shaharTechGit/Generic_Gate_Driver/Project_Book_8034_GENERIC_GATE_DRIVER_v110525_git.pdf

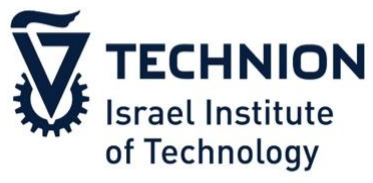
[picture p34: figure]
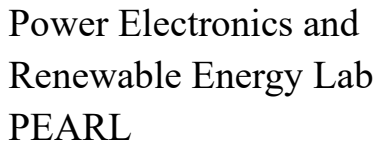
[picture p35: figure]
Power Electronics and Renewable Energy Lab PEARL

GENERIC GATE DRIVER

# Generic Gate Driver

# IGBTs, CoolSiC, USiC

# EVALUATION OF

# Infineon EiceDRIVER

# חורף תשפ"ה

# ספר פרויקט - 8034

## מבצעים: מאור ושחר

## מנחה: אריק

תודות

ילנה )ומנשה( –

עם המון סבלנות, עזר ו לבחון ולבחור בפתרונות. כמובן גם לחבר ולנתק ולספק

את העזרים הנדרשים.

לידור )ותום( –

עם התעניינות, שאלות קטנות במעבדה, עזרה במדידות ועבודה עם מכשירים.

אריק –

שהקשיב לנו, הב ין אותנו, עזר, דחף קדימה וגם שחרר כשהיה צריך.

הכל בצורה נעימה ועם חיוך.

תוכן עניינים

רשימת איורים 4 |
.1 תקציר5 |
.2 רשימת קיצורים 6 |
.3 מבוא 6 |
.3.1 הגדרות ושפה משותפת7 |
.3.2 עבודות קודמות 7 |
.3.3 מבנה העבודה – שלבים8 |
.4 תיאור כללי של הכרטיס והמערכת 9 |
11 | )Arduino Uno R3( | בקר | - | מיקרו | .4.1
.4.2 אספקת המתח במעגל12 |
.4.3 תשתית חיבור ובקרה 12 |
.5 רכיבים מרכזיים במערכת 12 |
12 | Infineon 1ED3321MC12N – | הדרייבר | .5.1
13 | Infineon IKW40N120H3 - IGBT | טרנזיסטור | .5.2
13 | UnitedSiC UJ4C075018K3S - SiC MOSFET | טרנזיסטור | .5.3
.6 פירוט תהליך הפיתוח ושלבי העבודה 14 |
.6.1 שלב ראשוני – הפעלה בסיסית של הכרטיס 14 |
.6.2 הפעלה עם מתח גבוה ובדיקות עומס 15 |
6.3. החלפת הטרנזיסטורים והגדרת התאמות 15 |
6.4. שיקולים נוספים ותכנון מבנה גנרי 16 |
.7 ניתוח תוצאות 16 |
.8 מסקנות והמלצות 17 |
8.1. מסקנות עיקריות17 |
8.2. אתגרים שעלו 17 |
.8.3 המלצות להמשך17 |
.9 נספחים 19 |
9.1. בדיקות ותוצאות 19 |
9.2. קוד בקר ארדואינו 19 |
9.3. פתרון אלטרנטיבי - מעגל תומך 19 |
9.4. הוראות הפעלה 20 |

9.5. קישורים - לינקים 20 |
.10 רשימת מקורות 21 |

רשימת איורים

7 | Infineon Eval-1ED3321MC12N - | איור | 1 Figure
Figure 2 איור – דיאגרמת בלוקים של שלבי העבודה 8 |
Figure 3 איור - דיאגרמת החיבורים 9 |
Figure 4 איור – טרנזיסטור עליון HS פתוח להולכה 10 |
Figure 5 איור - טרנזיסטור תחתון LS פתוח להולכה 10 |
Figure 6 איור – טבלת מצבי ההפעלה 11 |
Figure 7 איור - מיקרו-בקר ארדואינו, המחשה של זמן מת 11 |
13 | Infineon 1ED3321MC12N | דרייבר | - | איור | 8 Figure
13 | IGBT - Infineon IKW40N120H3 | טרנזיסטור | - | איור | 9 Figure
14 | SiC MOSFET - UnitedSiC UJ4C075018K3S | טרנזיסטור | - | איור | 10 Figure
Figure 11 איור - PWM גל משלים מהמיקרו בקר 14 |
Figure 12 איור -סכימת חיבור נגדי העומס בצד המתח הגבוה 15 |
Figure 13 איור - פתרון אלטרנטיבי מעגל תומך 19 |
Figure 14 איור – פתרון אלטרנטיבי חיבור למעגל הקיים 20 |

## .1 תקציר

במסגרת פרויקט זה נבחן ואופיין כרטיס אב -טיפוס של חברת Infineon דגם

N12MC3321ED-1Eval, המשמש כדרייבר מבודד להפעלת טרנזיסטורים מסוג

IGBT בתצורת Bridge-Half. המטרה המרכזית של הפרויקט הייתה לאפשר

שימוש גמיש בכרטיס, כך שיתאים גם לטרנזיסטורים מסוג MOSFET SiC

(Carbide Silicon(, ובכך להרחיב את השימושיות שלו לטובת פרויקטים עתידיים

במעבדת הספק.

במסגרת העבודה נותח מבנה הכרטיס והוגדרו ההתאמות הנדרשות להחלפת

סוג הטרנזיסטורים, תוך התחשבות בשוני בין הטכנולוגיות מבחינת מאפייני

מיתוג , דרישות מתח ובטיחות. פותח סט-אפ ניסיוני הכולל מיקרו-בקר ליצירת

אותות PWM מותאמים, ונבחנו מדידות מייצגות למתחי ם השונים

על-גבי שני סוגי הטרנזיסטורים. | DV ,GV ,CV , GV

התוצר הוא תשתית גנרית להפעלת טרנזיסטורים בתצורת Bridge-Half,

שתאפשר שימוש חוזר , בטוח וגמיש בכרטיסים קיימים במעבדה לצרכים

ניסיוניים מגוונים.

## Abstract

This project focuses on the evaluation and adaptation of Infineon's Eval-

1ED3321MC12N evaluation board, originally designed as a dual-channel

isolated gate driver for IGBT transistors in a Half-Bridge configuration.

The main objective was to enable flexible use of the board with additional

transistor types—specifically, SiC MOSFETs (Silicon Carbide)—thereby

extending its applicability for future power electronics experiments in the lab .

The internal structure of the board was analyzed, and the necessary

adjustments for replacing the original IGBTs were defined, with attention to

differences in switching behavior, voltage requirements, and safety

considerations across technologies .

A dedicated experimental setup was developed using a microcontroller to

generate complementary PWM signals with appropriate dead time, and

representative measurements of Vge, Vce, Vgs, and Vds were performed for

both transistor types .

The result is a generic, lab-grade Half-Bridge gate driver platform that

enables safe, reusable, and flexible testing of various power transistors using

the same evaluation board.

## .2 רשימת קיצורים

Evaluation Board כרטיס בדיקה והערכה של רכיבים | Eval Board
Insulated Gate Bipolar Transistor | IGBT
Gate–Emitter Voltage Collector–Emitter Voltage | VGE VCE
Metal–Oxide–Semiconductor Field-Effect Transistor | MOSFET
Gate–Source Voltage Drain–Source Voltage | VGS VDS
Silicon Carbide | SiC
Pulse Width Modulation מיתוג באמצעות שינוי רוחב פולס | PWM
גבוה מתח – High Voltage | HV
Low-Side / High-Side צד עליון / צד תחתון | LS/HS
Printed Circuit Board מעגל מודפס | PCB

## .3 מבוא

במסגרת פרויקטים שונים המתבצעים במעבדת הספק, קיים צורך בתשתיות

מודולריות להפעלת טרנזיסטורים מסוגים שונים, תוך תמיכה בטופולוגיות מיתוג

. | וכדומה | Half-Bridge, Buck, Boost | כגון | מגוונות

השימוש בכרטיסים מוכנים מראש לצרכי ניסוי, פיתוח ואפיון , מאפשר חיסכון

ניכר בזמן, עשוי למנ וע שגיאות חיווט, ולתרום לסטנדרטיזציה של ניסויים.

תמונות הכרטיס שנבחר כבסיס לעבודה, N12MC3321ED-1Eval Infineon,

מופיע באיור .1 הכרטיס תוכנן במקור עבור הפעלת טרנזיסטורים מסוג IGBT,

אולם בפרויקט נבחנה האפשרות להרחיב את שימושו להפעלת טרנזיסטורים

מסוג MOSFET SiC. טרנזיסטורים מתקדמים בעלי יתרונות בולטים במהירות

מיתוג, עמידות תרמית, יעילות וכן היכרות טובה יותר של סטודנטים עם אופן

הפעולה שלהם.

המוטיבציה לפרויקט נובעת מן הצורך לאפשר גמישות בניסויים עתידיים, מבלי

להידרש לתכנון חומרה ייעודית לכל טכנולוגיה מחדש.

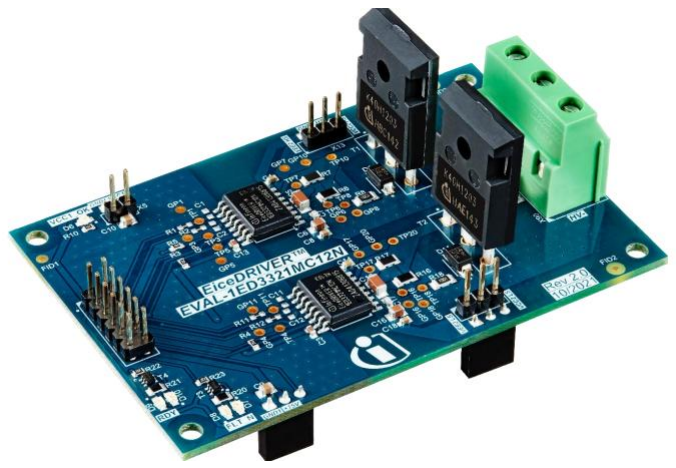
[picture p36: figure]

Infineon Eval-1ED3321MC12N - איור 1 Figure

.3.1 הגדרות ושפה משותפת

Driver Gate – רכיב המשמש לשליטה ישירה על שערי טרנזיסטורים, תוך

התאמת מתחי ם, בקרות הפעלה והגנות.

MOSFET SiC / IGBT – טכנולוגיות טרנזיסטור שונות, כל אחת בעלת מאפיינים

ייחודיים מבחינת מתחי הפעלה, קצב מיתוג, עמידות לרעש ועוד.

Time Dead – מרווח זמן בין כיבוי של טרנזיסטור אחד להפעלת השני בצד הנגדי

של Bridge-Half, שנועד למנוע מצב של through-shoot וסיכון הרכיבים.

Protection DESAT – מנגנון הגנה מפני זרמי יתר, באמצעות זיהוי עלייה חדה

במתח CV.

.3.2 עבודות קודמות

כרטיס ההערכה N12MC3321ED-1Eval Infineon פותח לצורך הדגמת הביצועים

של הדרייבר 1N12MC3321ED, עם יישומים עבור טרנזיסטורים מסוג IGBT. בדפי

הנתונים של הכרטיס מופיעה גם אפשרות לעבודה עם טרנזיסטורים מסוג

MOSFET™ CoolSiC, לרבות תרשימים לדוגמה ותצורות בדיקה.

עם זאת, בתצורתו המקורית הכרטיס תוכנן לשימוש עם זוג רכיבים קבועים,

ללא אפשרות החלפה פשוטה או שילוב של סוגים שונים של טרנזיסטורים

באותו סט -אפ ניסויי. בנוסף, לא סופקה תשתית גנרית לשילוב עם מיקרו-בקר

חיצוני ) כגון Arduino), ולא תועד תהליך אינטגרציה גמיש התואם לתרחישים

מעבדתיים מגוונים.

הפרויקט הנוכחי נועד להשלים את הפער הזה – באמצעות תכנון מערכת פתוחה , מודולרית, המאפשרת עבודה עם טרנזיסטורים מסוגים שונים תוך התאמות מבוקרות של המתח , בקרת זמן מת, ובדיקת תנאי מיתוג.

.3.3 מבנה העבודה – שלבים

באיור 2 מוצגת דיאגרמת בלוקים המסכמת את תהליך הפיתוח.

- ניתוח מבנה הכרטיס והבנת מנגנוני ההפעלה.
- PWM מהבקר לצורך יצירת אותות לשערי הטרנזיסטורים, כולל זמן מת

שנדרש כדי למנוע מצב בו שני הטרנזיסטורים מוליכים בו-זמנית.

- חיבורים מהבקר אל הכרטיס - הזנת אותות הדרייבר וחיבורי ספקי הכוח

למתחי השערים.

- אימות זרימת האותות מהבקר אל ה דרייברים ולבסוף אל שערי

הטרנזיסטורים, ללא שגיאות )מתחי שער נוצר ו בהצלחה(.

- חיבור ספק כוח במתח גבוה, להזנת מתח Vce בטרנזיסטורים, תוך שימוש

בנגדים המאפשרים נתיב זרם.

- ביצוע בדיקות עם הטרנזיסטורים מקוריים ) IGBT )לאימות תקינות.
- ביצוע מדידות על הטרנזיסטורים מקוריים ) IGBT )כאשר הם מחוברים

דרך מחברי בורג )Blocks Terminal).

- בדיקות צורך ויישום התאמות של הגנות ובקרה בהחלפת הטרנזיסטורים,

כגון זמן מת וערכי Resistor Gate.

- החלפת הטרנזיסטורים ל-MOSFET SiC והרצת בדיקות.
- גיבוש המלצות לתצורה גנרית של הכרטיס עבור שימושים עתידיים

במעבדה.

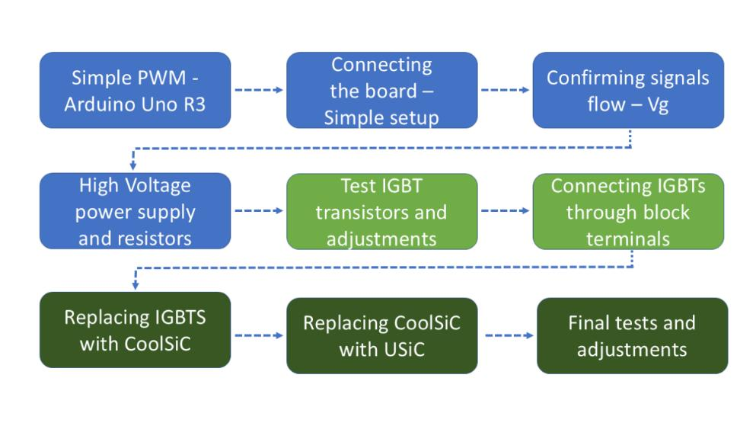
[picture p37: figure]

Figure 2 איור – דיאגרמת בלוקים של שלבי העבודה

## .4 תיאור כללי של הכרטיס והמערכת

בפרק זה נפרט את מבנה הכרטיס, אופן פעולתו, ונסביר את אופן החיבור שלו

למערכת הבדיקה. באיור 3 מופיע דיאגרמת החיבורים.

הפרויקט מבוסס על כרטיס ההערכה N12MC3321ED-1Eval Infineon, אשר

נועד להדגים את תפקודו של הדרייבר המבודד 1N12MC3321ED, בתצורת -Half

Bridge. הכרטיס כולל שני ערוצי דרייבר עם בידוד גלווני מלא ביניהם , כאשר כל

דרייבר מסוגל להפעיל טרנזיסטור ב-HS או LS בהתאם למתחי ההזנה.

המערכת כוללת שתי קבוצות הזנה נפרדות )בידוד מגלוון( עבור כל דרייבר:

HS | העליון | הדרייבר | עבור | VEE2_HS , VCC2_HS , GND2_HS -
LS | התחתון | עבור | VEE2_LS , VCC2_LS , GND2_LS -

בנוסף, קיימת כניסת בקרה לוגית , הכוללת חיבורים כגון :

- 1VCC – כניסת מתח לוגי )5V)
)High/Low( | הפעלה | כניסות | – INPH / INPL -
- N_RST – כניסת איפוס
- N_FLT / RDY – פלטים למצב הכרטיס

הכרטיס מופעל באמצעות מיקרו־בקר )Uno Arduino )המייצר אותות PWM,

ומחובר לכניסות של הדרייברים )+IN→INPH / -IN→INPL). יציאות הדרייבר

)OUTH/OUTL )מקושרות אל שערי הטרנזיסטורים, וכוללות רכיבי הגנה פנימיים

)כגון דחיפת המתח, DESAT, CLAMP).

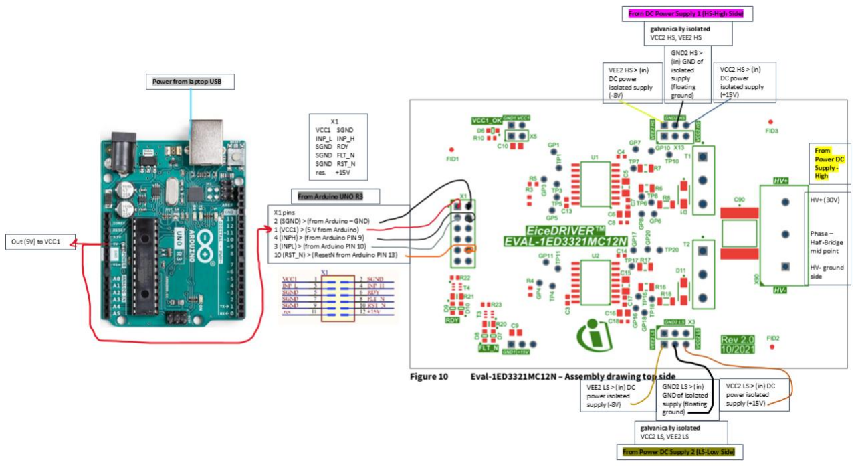
[picture p38: figure]

Figure 3 איור - דיאגרמת החיבורים

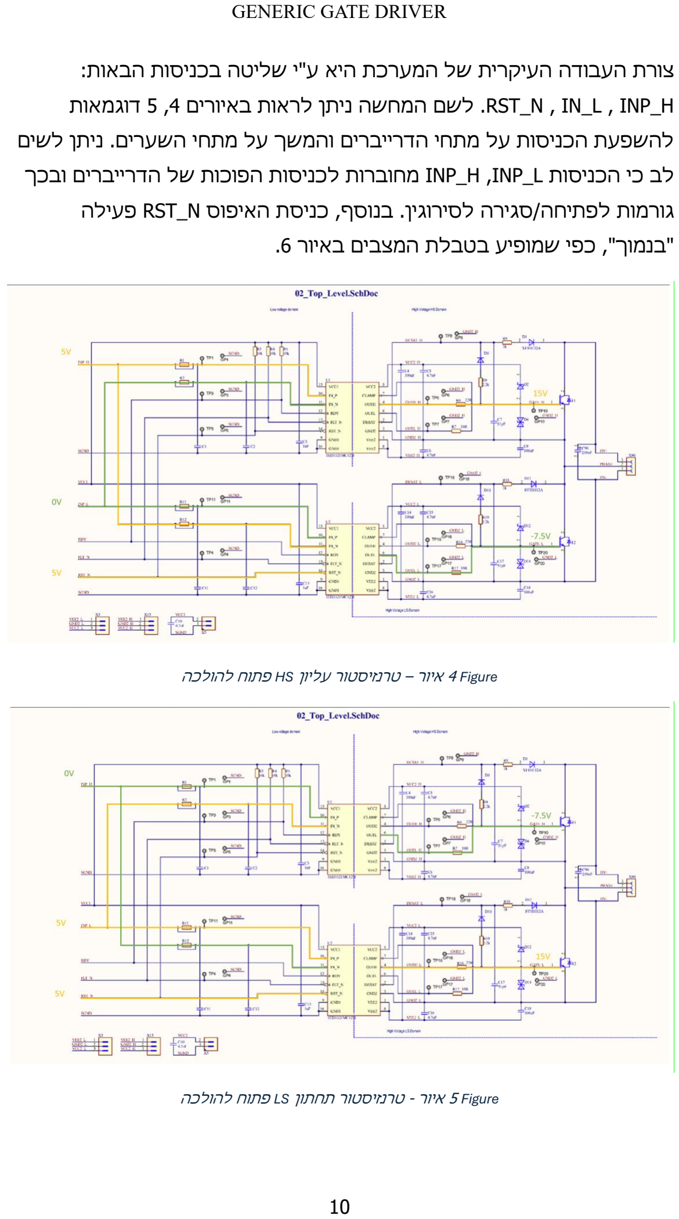
[picture p39: page 10]

צורת העבודה העיקרית של המערכת היא ע"י שליטה בכניסות הבאות:

H_INP , L_IN , N_RST. לשם המחשה ניתן לראות באיורים ,4 5 דוג מאות

להשפעת הכניסות על מתחי הדרייברים והמשך על מתחי השערים. ניתן לשים

לב כי הכניסות L_INP, H_INP מחוברות לכניסות הפוכות של הדרייברים ובכך

גורמות לפתיחה/סגירה לסירוגין. בנוסף, כניס ת האיפוס N_RST פעילה

"בנמוך", כפי שמופיע בטבלת המצבים באיור .6

Figure 4 איור – טרנזיסטור עליון HS פתוח להולכה

Figure 5 איור - טרנזיסטור תחתון LS פתוח להולכה

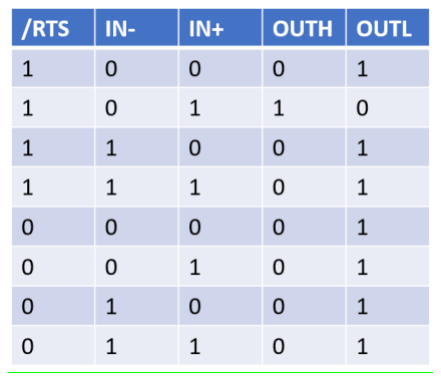
[picture p40: figure]

Figure 6 איור – טבלת מצבי ההפעלה

)Arduino Uno R3 ( | בקר | - | מיקרו | .4.1

לצורך שליטה על כניסות הדרייבר, חובר לכרטיס מיקרו־בקר מסוג -

3R Uno Arduino. הבקר הופעל באמצעות קוד ייעודי אשר מייצר זוג אותות PWM

משלימים עם זמן מת ) Time-Dead )מתואם, בתדר של kHz1 שניתן לשינוי.

החיבורים בין הבקר לכרטיס כללו את יציאות\ כניסות הבאים:

D9 (INPH) → IN+ ; D10 (INPL) → IN- | :PWM | אותות | -
D13 (RST_N) → /RST | : | איפוס | -
5V (VCC1) → VCC1 ; GND (SGND) → GND1 | :לוגי | צד | הזנת | -

ניתן למצוא מספר קבצי קוד שנצרבו על בקר הארדואינו בפרוייקט Git, הקישור

מופיע בנספחים.

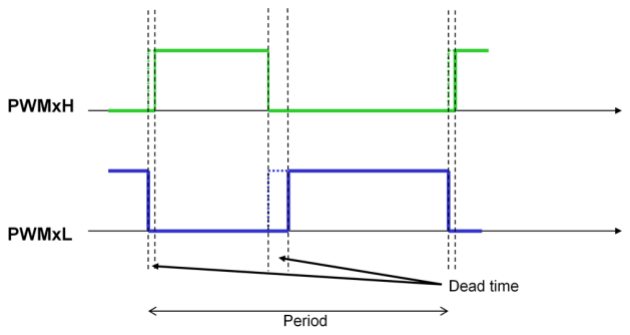
[picture p41: figure]
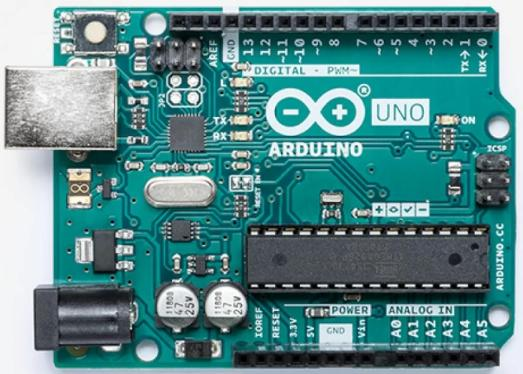
[picture p42: figure]

Figure 7 איור - מיקרו-בקר ארדואינו, המחשה של זמן מת

הערה חשובה:
במהלך העבודה נבחנו שני סוגי מימוש לקוד ה -PWM של הבקר: קוד פשוט ) מבוסס לולאות תוכנה( – ממומש באמצעות delayMicroseconds )(או לולאות loop, הקוד מאפשר זמן מת דו־צדדי , אך מוגבל לזמנים ארוכים יחסית , בסדר גודל של מיקרו־שניות - מיתוג איטי יחסית.
קוד מתקדם )מבוסס חומרת שעון פנימי – 1Timer – )

מנצל את יכולות ההשוואה והחומרה של 1Timer, מאפשר יצירת אותות מדויקים וזמן מת קצר בסדר גודל של ננו־שניות. עם זאת, הזמן המת הנתמך הוא חד-צדדי בלבד )בין HS ל־ LS, אך לא בכיוון ההפוך(, דבר שעלול לסכן את המעגל.
פתרונות חלופיים מופיעים בהמלצות להמשך.

.4.2 אספקת המתח במעגל

לצורך הפעלת הדרייבר ים, סופק מתח משני ספקי כוח נפרדים כאשר הערכים

נקבעו לפי סוג הטרנזיסטורים שחוברו:

עבור טרנזיסטור מסוג IGBT( 3H120N40IKW), חובר ספק מתח מבודד עבור ה-

HS עם הערכים : V,+15/-7.5 ספק נוסף עבור ה-LS עם אותם ערכים.

בנוסף, סופק מתח גבוה של V30 למעגל המיתוג עצמו )-HV / +HV), במטרה

ליצור מתחי DV / CV מתאימים לטרנזיסטורים ולבחון את תפקוד המערכת

במיתוג ממשי . בספק המתח הגבוה, הזרם הוגבל לערך של A1.5 .

)UJ4C075018K3S( USiC ,)IMW120R045M1( CoolSiC : | טרנזיסטורים | עבור

ערכי המתח בספקים היו LS\HS : V.+15/-2 כלומר השינוי המהותי בהחלפת

הטרנזיסטורים הוא מתח שער נמוך V-2 = VEE.

.4.3 תשתית חיבור ובקרה

מערך החיבורים כלל תכנון מבוקר לשם מניעת נזק לטרנזיסטורים, בפרט הושם

דגש על: אדמות צפות בין הדרייברים, שימוש בפרובים בצורה דיפרנציאלית

למדידות , שילוב נגדי עומס ליצירת נתיב זרם ברור.

## .5 רכיבים מרכזיים במערכת

Infineon 1ED3321MC12N – | הדרייבר | .5.1

הרכיב 1N12MC3321ED הוא דרייבר שער מבודד מסדרת TMEiceDRIVER של

חברת Infineon. דרייבר זה מתאים במיוחד להפעלת טרנזיסטורים בתצורות

Bridge-Half ומאפשר מיתוג מהיר, הגנה מפני זרמי יתר, תמיכה בטווח רחב של

מתחי הזנה בשער, הפעלה באמצעות אותות לוגיים ואותות סטטוס. בכרטיס

משולבים שני דרייברים כאלה, מבודדים זה מזה, עם ממשקי הפעלה ברורים

ונקודות מדידה מוגדרות מראש, דבר שמאפשר שליטה גמישה בעת שימוש

בבקר.

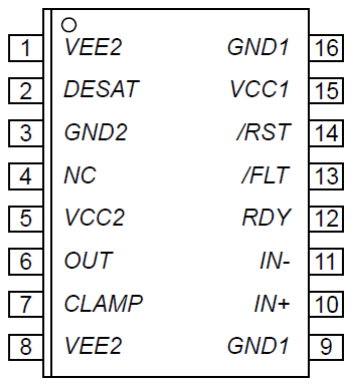
[picture p43: figure]
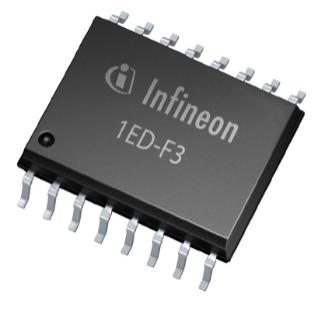
[picture p44: figure]

Infineon 1ED3321MC12N | דרייבר | - איור | 8 Figure
Infineon IKW40N120H3 - IGBT | טרנזיסטור | .5.2

רכיב זה שייך לסדרת 4IGBT™ TRENCHSTOP, והוא מיועד למתחי עבודה של

עד V1200  וזרמים של עד A.80

תכונות עיקריות:

- כולל דיודה אנטי־פרללית לפליטת זרמים חופשיים
- רמות הפסד נמוכות במצבים סטטיים ודינאמיים
- מתאים ליישומים עם תדרי מיתוג בינוניים עד kHz20~
- רגישות נמוכה ל -dt/dv בהשוואה ל־MOSFET

ה-IGBT מספק עמידות ויציבות, אך מגיב באופן איטי יותר בשער בהשוואה ל-

MOSFET SiC, מה שמצריך זמן מת משמעותי יותר.

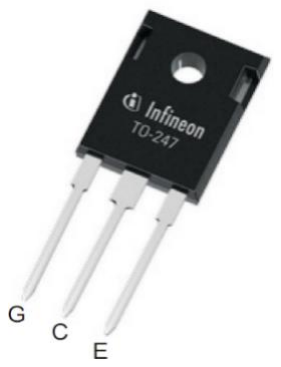
[picture p45: figure]
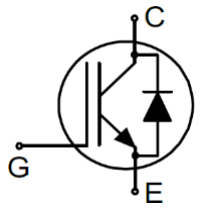
[picture p46: figure]

IGBT - Infineon IKW40N120H3 | טרנזיסטור | - | איור | 9 Figure
UnitedSiC UJ4C075018K3S - SiC MOSFET | טרנזיסטור | .5.3

רכיב זה מבוסס טכנולוגיית Carbide Silicon, ומיועד לזרמים גבוהים עם מיתוג

מהיר מאוד.

תכונות עיקריות:

- מתח עבודה עד V750  וזרם עד A60
- זמני עלייה וירידה בסדר גודל של ns20

- עמידות תרמית גבוהה
- רגישות גבוהה ל- dt/dV, לכן נדרש לוודא Resistor Gate תואם
- מתאים ליישומי מיתוג מהיר kHz100 ~ומערכות הדורשות יעילות גבוהה

בפרויקט, השימוש ברכיב זה דרש שיקולים בתכנון זמן מת, בדיקת תופעות

צלצולים, Overshoot, יצירת נתיב זרם מסודר להימנע מנזק וכמובן הגבלת זרם.

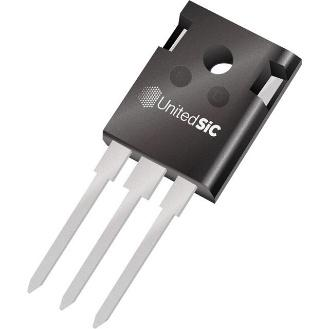
[picture p47: figure]
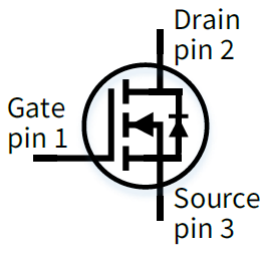
[picture p48: figure]

SiC MOSFET - UnitedSiC UJ4C075018K3S | טרנזיסטור | - | איור | 10 Figure

בנוסף לאלה, חובר ונבדק גם טרנזיסטור CoolSiC של Infineon. ניתן למצוא את

דפי הנתונים המלאים באינטרנט או יחד עם שאר הקבצים בפרוייקט ה-Git.

## .6 פירוט תהליך הפיתוח ושלבי העבודה

בקבצי הפרויקט מצורפים מסמכי בדיקה עבור כל אחד מסוגי הטרנזיסטורים,

הכוללים את אופן הבדיקה, תוצאות המדידה , וצילומי מסך של גלי הסקופ

)תחת התיקייה: Tests_and_Measurements). מומלץ לעיין בהם.

.6.1 שלב ראשוני – הפעלה בסיסית של הכרטיס

השלב הראשון כלל חיבור הדרייבר למיקרו־בקר מסוג 3R Uno Arduino, פיתוח קוד ראשוני ליצירת אותות PWM משלימים בתדר 1 kHz, ובדיקה של תגובת הדרייבר. ניתן לראות באיור 11 המחשה של האות המשלים לדוגמה.

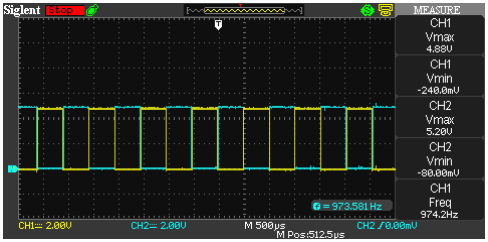
[picture p49: figure]

Figure 11 איור - PWM גל משלים מהמיקרו בקר

בהמשך בוצעה בדיקת תקינות הדרייבר ללא מתח גבוה, תוך שימוש במדידה דיפרנציאלית לקבלת Vge בטרנזיסטורים העליון והתחתון )HS ו-LS). התקבלו אותות תקינים, המאשרים פעולה תקינה של הדרייבר בשלב זה .

.6.2 הפעלה עם מתח גבוה ובדיקות עומס

בוצעו ניסויים עם ספק מתח גבוה V30 שהוגבל לזרם של A,1.5 הניסוי החל ללא עומס, ובהמשך חוברו נגדי עומס בהתאם לתרשים באיור .12 נמדדו מתחי Vce תקינים עבור שני הטרנזיסטורים, דבר המעיד על תפקוד תקין של תהליך מיתוג.

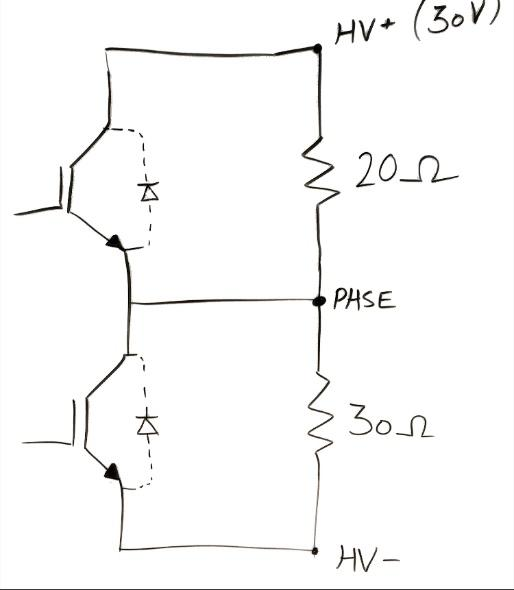
[picture p50: figure]

Figure 12 איור -סכימת חיבור נגדי העומס בצד המתח הגבוה
.6.3 החלפת הטרנזיסטורים והגדרת התאמות

לאחר אימות תקינות המעגל עם הטרנזיסטורים המקוריים ) IGBT), נשקלו פתרונות להחלפה מהירה של טרנזיסטורים ללא צורך בהלחמה . הוחלט
התואמים | ,(Same-Key | מתוצרת | TB003V-500( Terminal Block | במחברי | להשתמש
למתח ולזרם הנדרשים . זאת על מנת לאפשר מעבר מהיר בין סוגי הטרנזיסטורים ולאפשר חזרה על בדיקות, ללא צרוך בסיכון הכרטיס ע"י ניתוקים והלחמות חוזרות. הטרנזיסטורים המקוריים )IGBT ), חוברו מחדש באמצעות המחברים , והבדיקות עברו בהצלחה.

לפני החלפת הרכיבים ל-MOSFET USiC( דגם S3K075018C4UJ), נבדקו ההתנגדויות הקיימות בשערים לצמצום תופעות כמו ringing ו -overshoot. נמצא כי הנגדים המותקנים מספקים ערכים מתאימים, ולא נדרשו שינויים.

בנוסף, נבחן גם טרנזיסטור CoolSiC( 1M045R120IMW), אשר נבדק ע"י החברה ומופיע במסגרת דפי הנתונים של הכרטיס , כאמצעי זהירות ובמטרה לאשר תחילה תפקוד תקין על גבי הפלטפורמה.

במדידות שבוצעו לאחר ההחלפה , נצפו מתחים תקינים של Vge וכן Vce, כאשר התנהגות המיתוג הייתה מהירה יותר אך גם רגישה יותר לשיבושים .

.6.4 שיקולים נוספים ותכנון מבנה גנרי

במהלך הפרויקט נבחן רעיון למימוש לוח PCB גנרי אשר יכיל מספר זוגות של טרנזיסטורים מסוגים שונים . שליטת המיתוג תתבצע באמצעות רכיב דיקודר ומתגים דיגיטליים, כך שניתן יהיה לבחור זוג טרנזיסטורים אקטיבי לצורך ניסוי – מבלי להחליף רכיבים פיזית או להפעיל מחדש את המערכת. פיתוח הפתרון עזר לנו להבין טוב יותר את הדרישות ולבסוף נבחר פתרון חלופי. ניתן למצוא פירוט על כך בנספח – פתרון אלטרנטיבי.

## .7 ניתוח תוצאות

במהלך הפרויקט בוצעו סדרות בדיקה מסודרות עבור שלושה סוגי

.USiC -ו CoolSiC , IGBT : | טרנזיסטורים

לכל טרנזיסטור נבחנו המדדים המרכזיים: Vge \ Vgs , Veg \ Vds, התנהגות

נקודת הפאזה )PHASE), זמן מת )Time-Dead )ו יציבות תזמון לאורך זמן .

הבדיקות בוצעו בתנאי הפעלה זהים: תדר PWM של kHz,1 זמן מת µs,4-8 מתח

גבוה V,30 זרם מוגבל ל -A.1.5 מדידה באמצעות אוסצילוסקופ 4 ערוצים.

ממצאים מרכזיים :

עבור IGBT, נצפו אותות שער תקינים )V/−7.5V+15), מיתוג יציב , וגלי פאזה

חלקים ללא צלצולים חריגים .

עבור CoolSiC, התקבל מיתוג חד ומהיר יותר, עם overshoot קל בשערים, אך

במתח תקני.

עבור USiC, המיתוג היה המהיר ביותר, אך גם הציג רגישות גבוהה יותר

לאפקטים פרזיטי ים והפרשי overshoot בין ערוצי הדרייבר .

בשלושת המקרים, המערכת תפקדה בצורה תקינה והציגה שליטה יציבה על

תהליך המיתוג.

זמן המת שנקבע בתוכנת הארדואינו שמר על רווח נדרש בין הפעלות , אם כי

נצפו הבדלים בין כיוון LS→HS לבין HS→LS – תופעה שקשורה למימוש ה-PWM

ומגבלות הבקר.

נזכיר שבקבצי הפרויקט מצורפים מסמכי בדיקה מפורטים עבור כל אחד מסוגי

הטרנזיסטורים, הכוללים את אופן הבדיקה, תוצאות המדידה, וצילומי מסך של

גלי הסקופ )תחת התיקייה : Tests_and_Measurements).

## .8 מסקנות והמלצות

.8.1 מסקנות עיקריות

במהלך העבודה הושגה מטרה מרכזית של פיתוח תצורה גנרית להפעלת

טרנזיסטורים שונים באמצעות כרטיס N12MC3321ED-1Eval.

הכרטיס פעל בהצלחה עם IGBT, CoolSiC ו-USiC, תוך שמירה על מתחי שער

מתאימים , זמן מת תקני ומיתוג יציב. השילוב עם בקר Arduino אפשר הפעלה

פשוטה ונוחה, כולל בקרה מדויקת יחסית על זמני המיתוג והתאמה בין

הערוצים. בנוסף, שילוב מחברי Block Terminal סיפק פתרון ונתן מענה יעיל

להחלפה מהירה של רכיבים , ללא צורך בהלחמות חוזרות. ע ם זאת, ייתכן

שהשימוש במחברים אלה פגע במידת מה בדיוק האותות ובאמינות המדידה .

.8.2 אתגרים שעלו

הושג זמ ן מת בטוח, אך לא סימטרי, בשל מגבלות חומרה של הבקר, התאפשרו

שני מצבים. האחד התקבל ע"י מימוש פשוט ונתן זמן מת גדול יחסית )מיקרו -

שניות( ולא סימטרי. השני, כאשר נעשה שימוש ב-PWM מבוסס חומרה. במקרה

זה התקבל זמן מת קצר )בסדר גודל של ננו־שניות(, אך רק בצד אחד – דבר

שיצר סיכון ממשי ל-through-shoot.

נצפו אפקטים של overshoot ו-undershoot במתחים בעיקר ב-SiC, בסדרי גודל

של עד .15% אנו מעריכים שתופעות אלה הן תוצאה של ממיתוג מהיר, היעדר

snubber ואפקטים פרזיטיים הקשורים לחיבור הטרנזיסטורים באמצעות מחברים

ולא באופן ישיר.

נדרשה זהירות במדידה , בעיקר במדידות דיפרנציאליות של Vge עבור הצד העליון והצד התחתון ) HS ו-LS )בו זמנית. כאשר במקרים מסוימים נדרשה חישוביות )פונקציית Math בסקופ( מהערוצים לצורך קבלת Vge. עובדה זו עשויה להשפיע על דיוק התוצאות שנמדדו בפועל.

.8.3 המלצות להמשך

קיצור זמן המת לסדרי גודל של ns,200 במיוחד עבור טרנזיסטורים מסוג SiC,

בכפוף לאימות מיתוג תקין. לקבלת דיוק ושליטה טובים יותר.

פתרונות אפשריים עבור PWM:

שימוש בבקר מתקדם יותר )כגון 32STM )המאפשר שליטה מלאה בשני ערוצי

PWM עם זמן מת דו -צדדי חומרתי .

שימוש במכולל אותות מקצועי )Generator Function )עם תמיכה באותות

משלימים ושליטה בזמן מת.

שילוב רכיב ייעודי למיתוג )IC Driver )עם שליטה פנימית על זמן מת.

שילוב סליל בעומס יאפשר בחינת המיתוג בתצורת Bridge-Half מלאה, בדומה

ליישום מעשי.

תכנון והדפסת PCB עבור כל זוג טרנזיסטורים )USiC ,CoolSiC ,IGBT )יאפשר

חיבור נוח , קבוע ובטוח , תוך ארגון טוב יותר של הכניסות והיציאות .

שילוב ההתקן בתוך טופולוגיית ממיר שלמה, לשם בדיקה של תפקוד המערכת

תחת עומס ולשם אימות שליטה מלאה במיתוג בפועל.

## .9 נספחים

הנספחים מופעים בקבצי הפרויקט שנמצאים ב-git :

### https://github.com/shaharTechGit/Generic_Gate_Driver

.9.1 בדיקות ותוצאות

קיימים בקבצי הפרוייקט מסמכי בדיקות מפורטים לכל סוג טרנזיסטור )בפורמת word). איך לבדוק, מה התוצאות המצופות, מה קיבלנו בפועל והסברים. הקבצים מכילים בדיקות בסיסיות בסדר כרונולוגי, והמלצות לבדיקות המשך יותר מורכבות.
)Measurements_and_Tests | תיקיית | )

.9.2 קוד בקר ארדואינו

קיימים בקבצי הפרוייקט מספר אפשרויות, הקבצים בעלי שמות אינפורמטיביים והערות מפורטות על תוכן הקוד ואפשרויות לשינויים )במידת האפשר(.
)Arduino_Uno_R3_PWM_Code | תיקיית | )

.9.3 פתרון אלטרנטיבי - מעגל תומך

אחת הדרישות בפרוייקט הייתה לתת מענה לדרישה להפעיל סוגים שונים של טרנזיסטורים ע"י אותו המעגל. הרעיון שהוצע הוא מעגל המכיל זוג מפענחים , רכיב דוחף אשר מספק הספק גבוה יותר במוצא מההספק המסופק מהמפענחים שבעזרתו ניתן יהיה לשלוט על המתחים המכניים אשר בעזרתם נוכל לחבר את זוגות הטרנזיסטורים בנפרד האחד מהשני למעגל. בכניסה לכל טרנזיסטור מחוברות דיודות זנר אשר תפקידן הגבלת המתח ב-gate של הטרנזיסטורים. הרעיון הכללי היה שע"י שליטה במפענחים נוכל בכל פעם לבחור אילו מתגים נסגרים ובכך עם איזה זוג של טרנזיסטורים יעבוד המעגל.

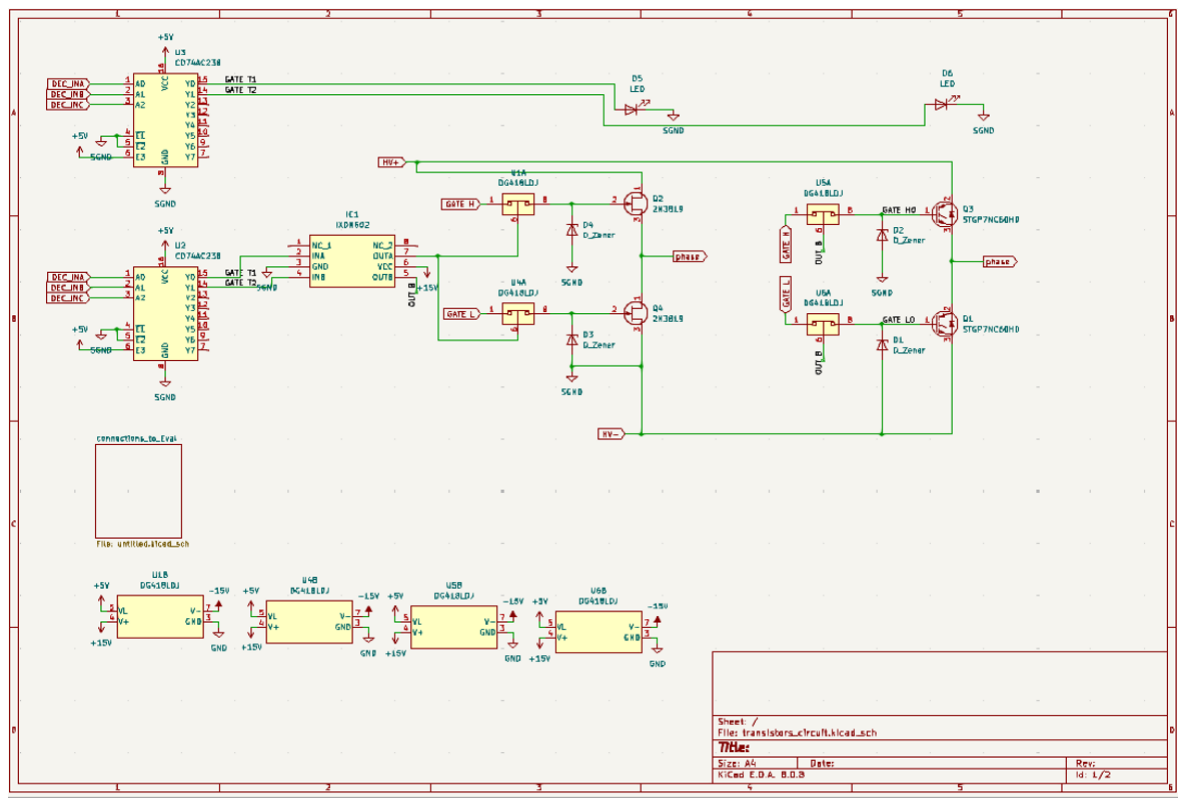
[picture p51: figure]

Figure 13 איור - פתרון אלטרנטיבי מעגל תומך

רעיון זה לא התקדם עקב מגבלות אשר קיימות במתגים , ואשר עלולים להרע לפעולה מיטבית של הטרנזיסטורים, לכן להמשכו של הפרוייקט יבנה מעגל אשר יקח את צורת העבודה של המעגל הקיים ובצורה פרטנית תיבנה מעטפת אשר תספק שימוש מיטבי עם הטרנזיסטורים . ניתן לראות פירוט נוסף במצגת הפרויקט.

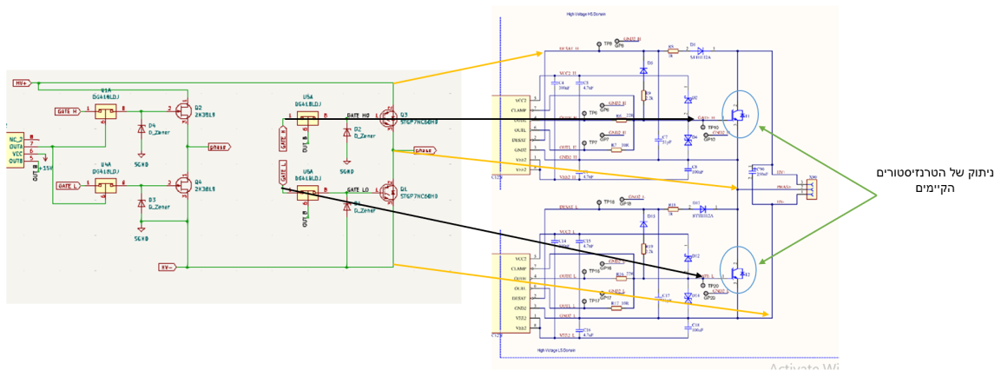
[picture p52: figure]

Figure 14 איור – פתרון אלטרנטיבי חיבור למעגל הקיים
.9.4 הוראות הפעלה

הוראות הפעלה מק וצרות נמצאות ב-git( ReadMe), יחד עם סרטון הפעלה לדוגמה.

.9.5 קישורים - לינקים

### https://github.com/shaharTechGit/Generic_Gate_Driver – Git

קישור לדרייב טכניוני ) גישה מוגבלת – ניתן לבקש הרשאה( –

### https://technionmail-my.sharepoint.com/:f:/r/personal/xzamir_campus_technion_ac_il/Documents/P

roject%20-%20GENERIC%20GATE%20DRIVER?csf=1&web=1&e=VPK1vo (https://technionmail-my.sharepoint.com/:f:/r/personal/xzamir_campus_technion_ac_il/Documents/Project%20-%20GENERIC%20GATE%20DRIVER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)

## .10 רשימת מקורות

Arduino Uno R3:
https://docs.arduino.cc/tutorials/uno-rev3/getting-started/

Eval-1ED3321MC12N - Evaluation board: https://www.infineon.com/cms/en/product/evaluation-boards/eval-1ed3321mc12n/ (https://www.infineon.com/cms/en/product/evaluation-boards/eval-1ed3321mc12n/)

Infineon-1ED332xMC12N – EiceDriver: https://www.infineon.com/dgdl/Infineon-1ED332xMC12N-DataSheet-v01_03-EN.pdf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 (https://www.infineon.com/dgdl/Infineon-1ED332xMC12N-DataSheet-v01_03-EN.pdf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)

EVAL-PSIR2085:
https://www.infineon.com/dgdl/Infineon-UG-2021-33_EVAL-PSIR2085-UserManual-v01_00-EN.pdf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 (https://www.infineon.com/dgdl/Infineon-UG-2021-33_EVAL-PSIR2085-UserManual-v01_00-EN.pdf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)

Infineon-IKW40N120H3 – IGBT Transistor: https://www.infineon.com/cms/en/product/power/igbt/igbt-discretes/ikw40n120h3/ (https://www.infineon.com/cms/en/product/power/igbt/igbt-discretes/ikw40n120h3/)

Infineon-IMW120R045M1 – CoolSiC Transistor:

https://www.infineon.com/cms/en/product/power/mosfet/silicon-carbide/discretes/imw120r045m1/ (https://www.infineon.com/cms/en/product/power/mosfet/silicon-carbide/discretes/imw120r045m1/)

Silicon Carbide (SiC) – USiC Transistor:

https://www.onsemi.com/download/data-sheet/pdf/uj4c075018k3s-d.pdf
