shaharTechGit/Generic_Gate_Driver/Pictures/Schematic_View.jpg

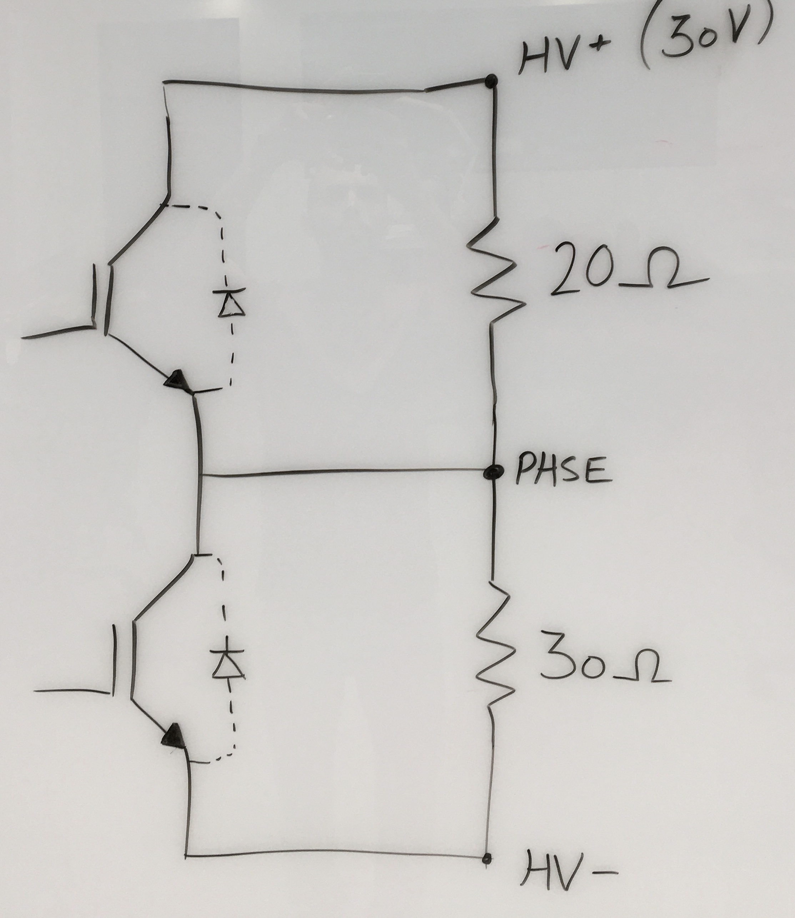
Pictures/Schematic_View.jpg
