shaharTechGit/Generic_Gate_Driver/Measurements_and_Tests/1_PWM_first_version_with_dead_time_fualt/IGBT_test4_+15_-7,5_30V_1.5A_more_dead_time_asymetric_LS_to_HS.BMP

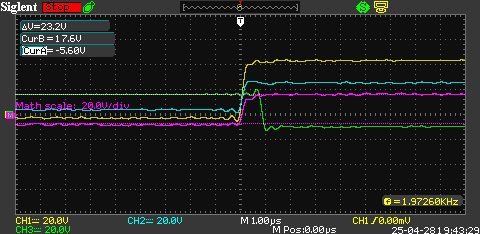
Measurements_and_Tests/1_PWM_first_version_with_dead_time_fualt/IGBT_test4_+15_-7,5_30V_1.5A_more_dead_time_asymetric_LS_to_HS.BMP
