shaharTechGit/Generic_Gate_Driver/Measurements_and_Tests/2_IGBT_new_arduino_PWM_micro_sec_dead_time/IGBT_test2_+15_-7,5_30V_1.5A_Vge_LS.BMP

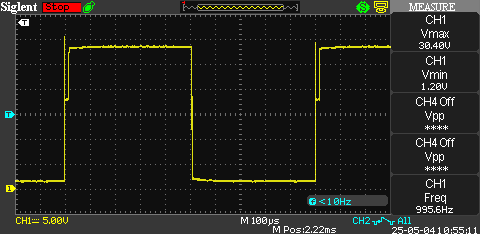
Measurements_and_Tests/2_IGBT_new_arduino_PWM_micro_sec_dead_time/IGBT_test2_+15_-7,5_30V_1.5A_Vge_LS.BMP
