shaharTechGit/Generic_Gate_Driver/Measurements_and_Tests/3_PWM_CoolSiC_nano_dead_time_one_side/CoolSiC_test1_with_high_voltage_ON/CoolSiC_test1_+15_-2_30V_1.5A_Vgs_HS(high_voltage_ON)_zoom_overshoot.BMP

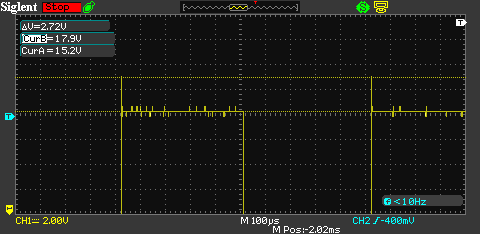
Measurements_and_Tests/3_PWM_CoolSiC_nano_dead_time_one_side/CoolSiC_test1_with_high_voltage_ON/CoolSiC_test1_+15_-2_30V_1.5A_Vgs_HS(high_voltage_ON)_zoom_overshoot.BMP
