shaharTechGit/Generic_Gate_Driver/Measurements_and_Tests/3_PWM_CoolSiC_nano_dead_time_one_side/D9_toD10_good.BMP

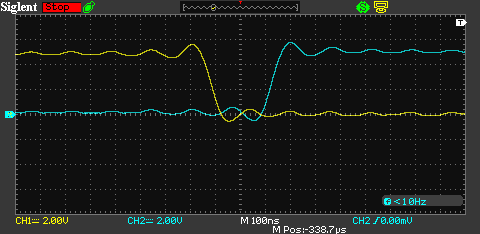
Measurements_and_Tests/3_PWM_CoolSiC_nano_dead_time_one_side/D9_toD10_good.BMP
