shaharTechGit/Generic_Gate_Driver/Measurements_and_Tests/4_PWM_USiC_nano_sec_dead_time_only_one_side/test0/D9.BMP

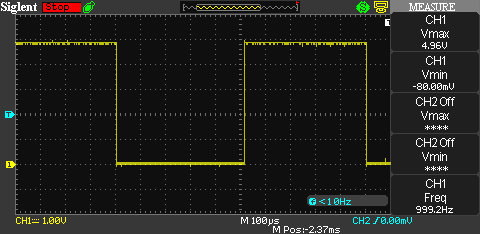
Measurements_and_Tests/4_PWM_USiC_nano_sec_dead_time_only_one_side/test0/D9.BMP
