shaharTechGit/Generic_Gate_Driver/Measurements_and_Tests/4_PWM_USiC_nano_sec_dead_time_only_one_side/test0/D9_vs_D10__TP1_to_GP1_TP11_to_GP1_dead_time.BMP

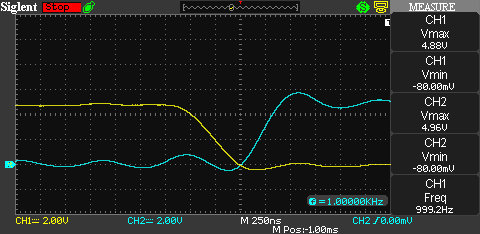
Measurements_and_Tests/4_PWM_USiC_nano_sec_dead_time_only_one_side/test0/D9_vs_D10__TP1_to_GP1_TP11_to_GP1_dead_time.BMP
