shaharTechGit/Generic_Gate_Driver/Measurements_and_Tests/5_PWM_USiC_micro_sec_dead_time/test2/USiC_test2_+15_-2_30V_1.5A_Vds_HS_zoom.BMP

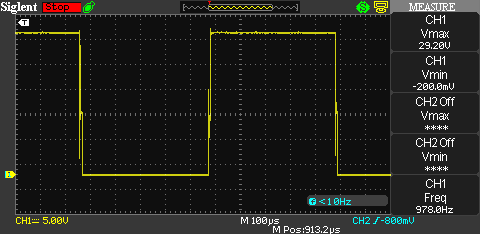
Measurements_and_Tests/5_PWM_USiC_micro_sec_dead_time/test2/USiC_test2_+15_-2_30V_1.5A_Vds_HS_zoom.BMP
