shaharTechGit/Generic_Gate_Driver/Measurements_and_Tests/5_PWM_USiC_micro_sec_dead_time/test4/no_high_voltage.BMP

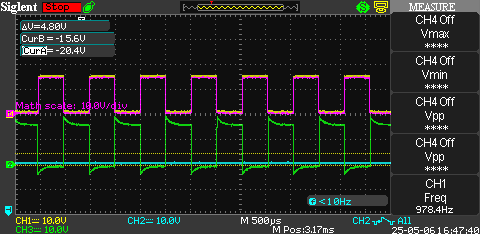
Measurements_and_Tests/5_PWM_USiC_micro_sec_dead_time/test4/no_high_voltage.BMP
