shaharTechGit/Generic_Gate_Driver/Measurements_and_Tests/5_PWM_USiC_micro_sec_dead_time/test4/Vmax_Vmin_are_out_of_boundries_check_data_sheet.BMP

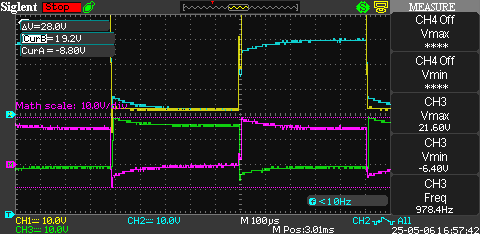
Measurements_and_Tests/5_PWM_USiC_micro_sec_dead_time/test4/Vmax_Vmin_are_out_of_boundries_check_data_sheet.BMP
